rch16/SmartCrutch/ExerciseTracker/Figures/Skeletal Profile - Arm Raises (ex 1).png

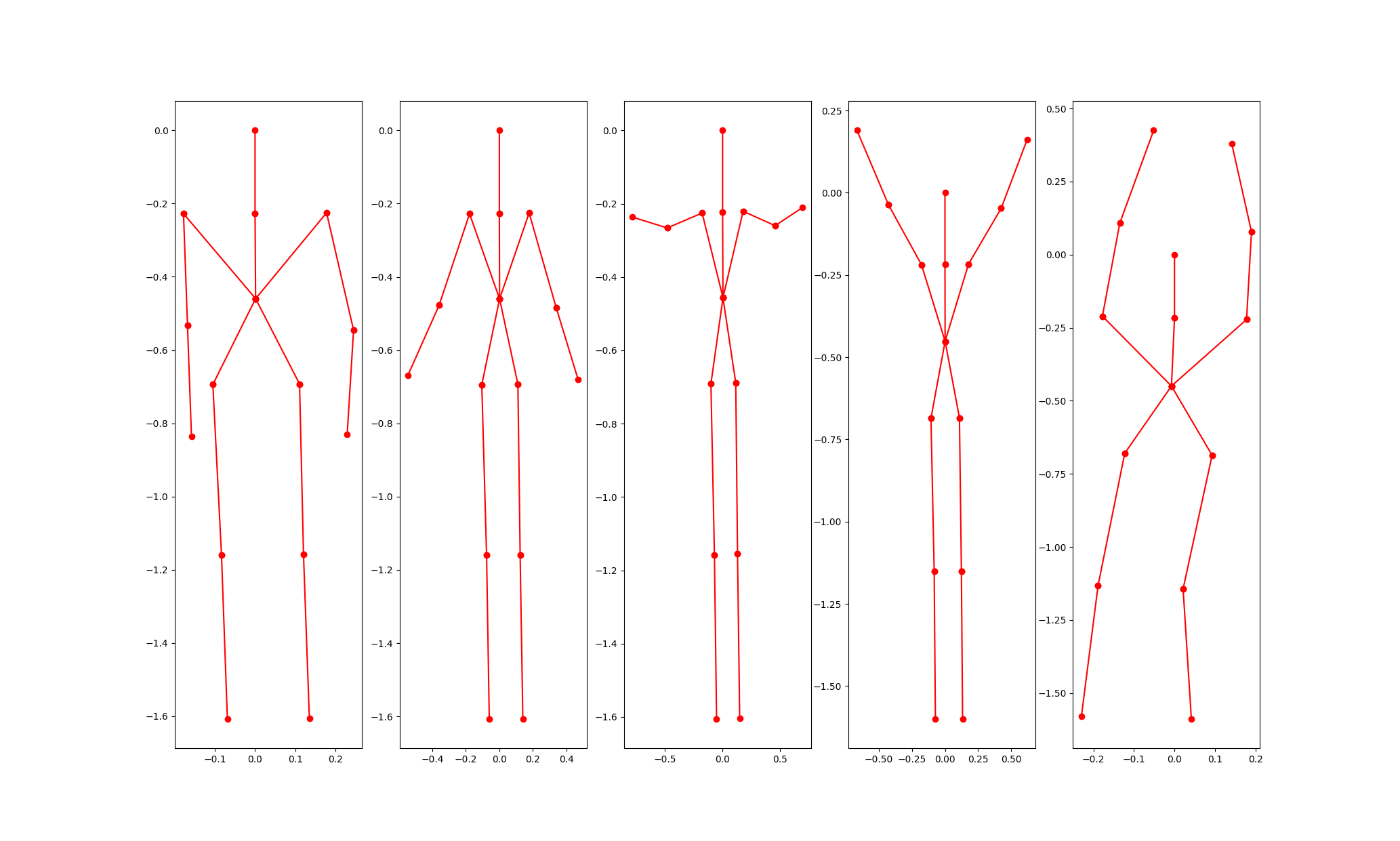
ExerciseTracker/Figures/Skeletal Profile - Arm Raises (ex 1).png
