rch16/SmartCrutch/ExerciseTracker/Figures/Skeletal Profile - Left Knee Raise (ex 3).png

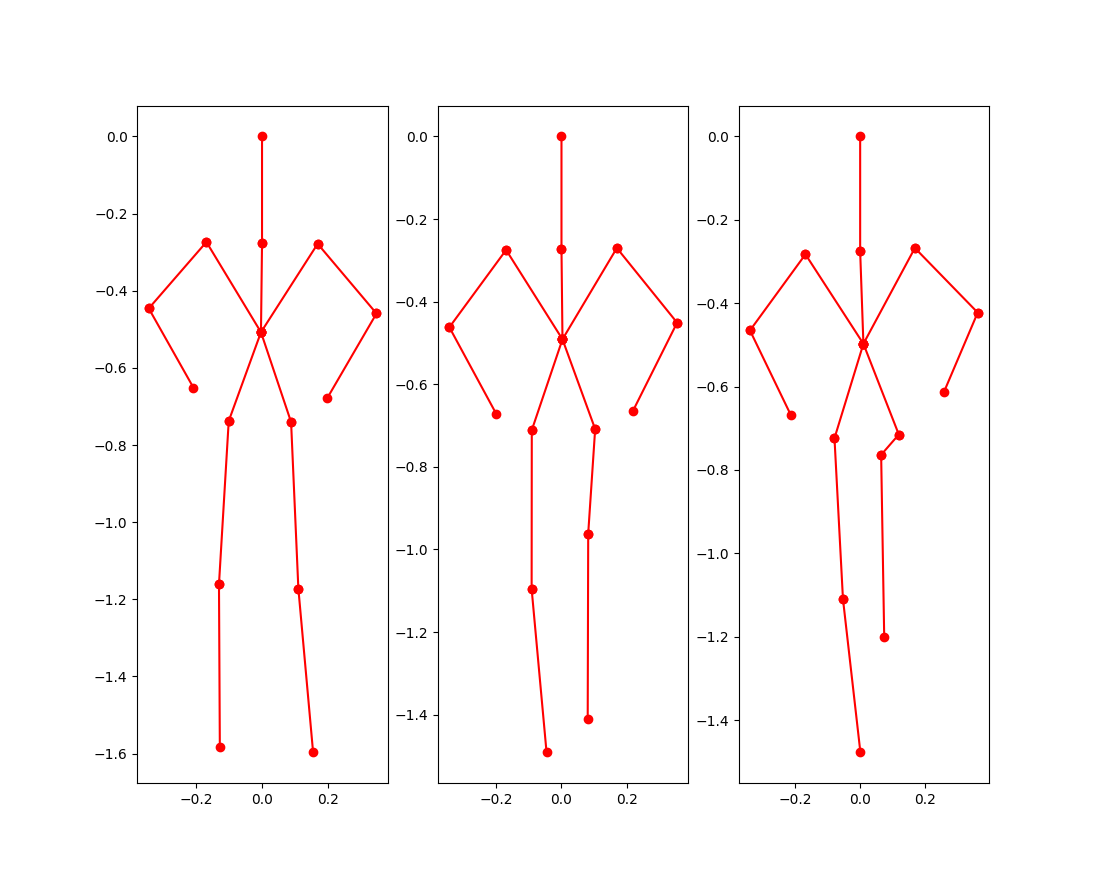
ExerciseTracker/Figures/Skeletal Profile - Left Knee Raise (ex 3).png
