rch16/SmartCrutch/ExerciseTracker/Figures/Skeletal Profile - Left Lateral Leg Raise (ex 2).png

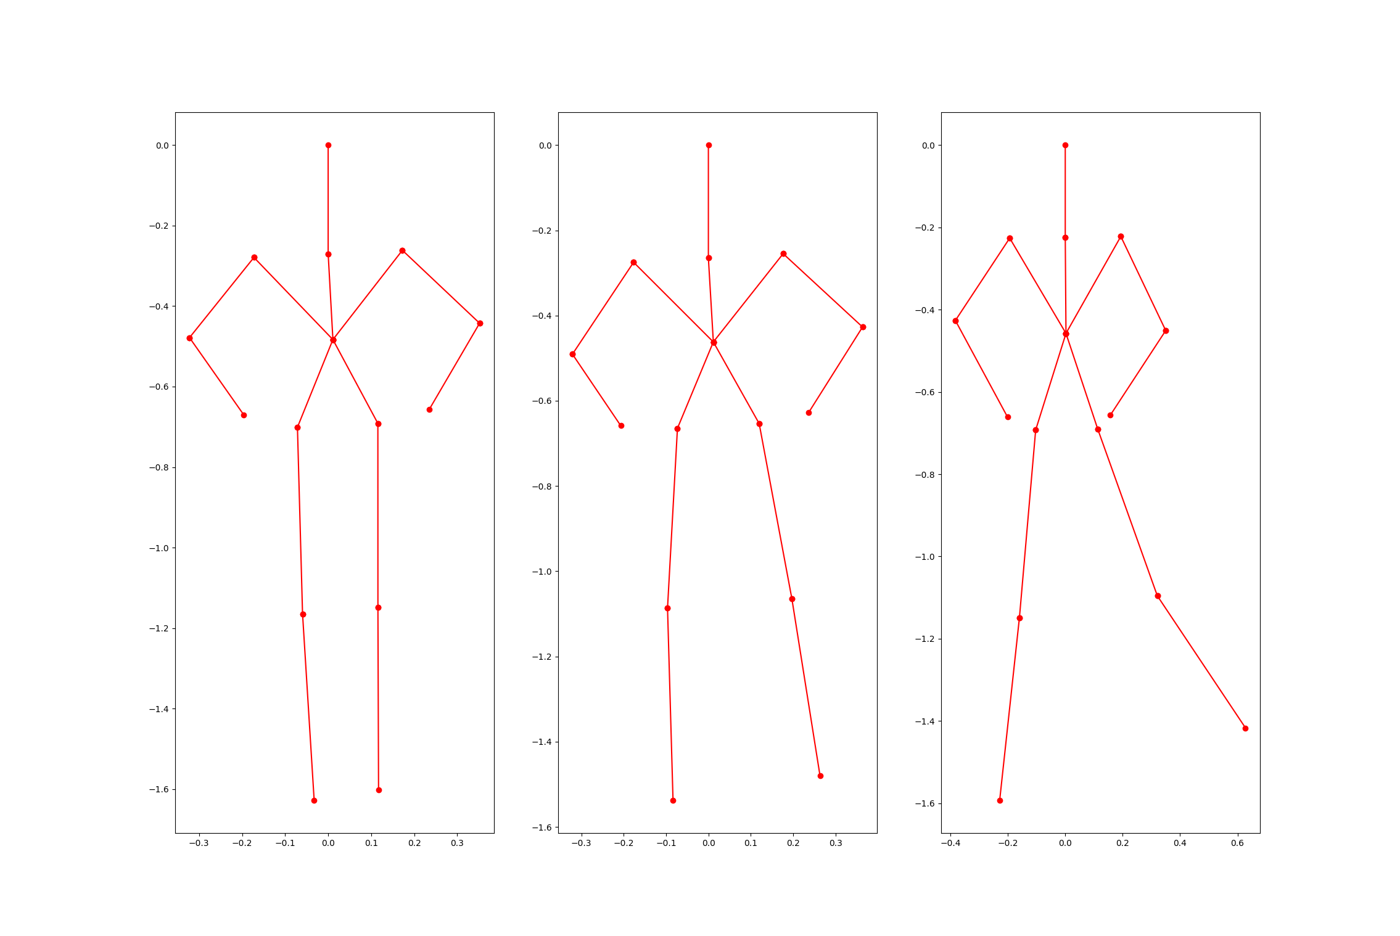
ExerciseTracker/Figures/Skeletal Profile - Left Lateral Leg Raise (ex 2).png
