rch16/SmartCrutch/ExerciseTracker/Figures/Skeletal Profile - Right Knee Raise (ex 4).png

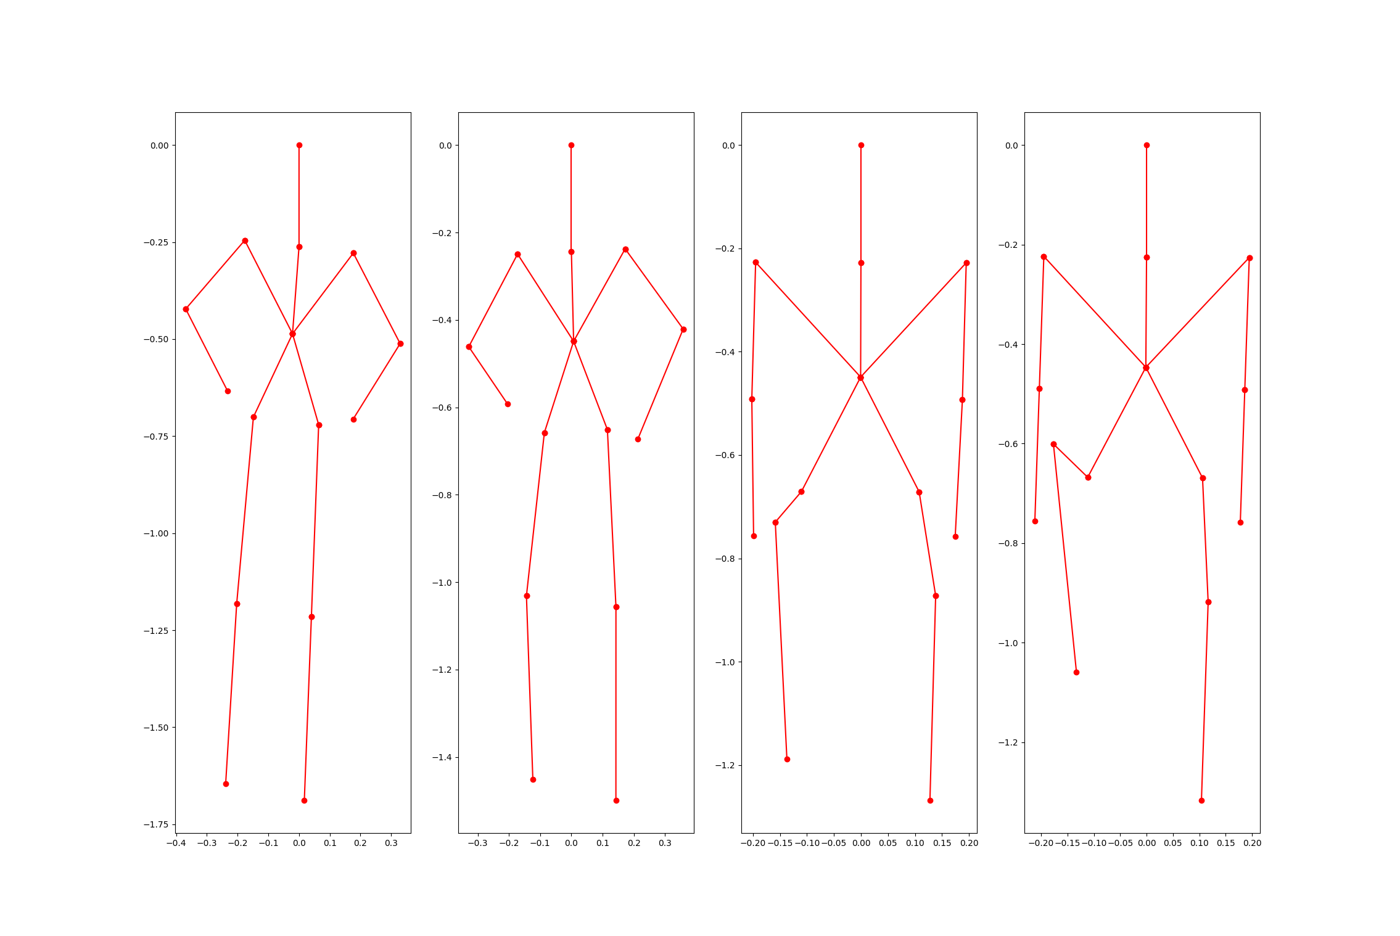
ExerciseTracker/Figures/Skeletal Profile - Right Knee Raise (ex 4).png
