rch16/SmartCrutch/SmartCrutches/FullSystem/CrutchSystem/full_system/full_system.ino

#include <ESP8266WiFi.h>
#include <Wire.h>
#include <WiFiClientSecure.h>
#include <StackThunk.h>

#include "FS.h"
#include "HX711.h"

// Parameter Config
#define SENSOR_SAMPLE_INTERVAL 10000 // Interval between individual IMU/Weight samples in microseconds
#define SENSOR_SAMPLE_SIZE 300 // Number of sensor samples in each period
#define DAILY_SAMPLES 100 // Number of gait samples per day

// i2c addresses
#define MPU9250_ADDRESS 0x68
#define MAG_ADDRESS 0x0C

// Range configuration bytes
#define GYRO_FULL_SCALE_250_DPS 0x00 
#define GYRO_FULL_SCALE_500_DPS 0x08
#define GYRO_FULL_SCALE_1000_DPS 0x10
#define GYRO_FULL_SCALE_2000_DPS 0x18
 
#define ACC_FULL_SCALE_2_G 0x00 
#define ACC_FULL_SCALE_4_G 0x08
#define ACC_FULL_SCALE_8_G 0x10
#define ACC_FULL_SCALE_16_G 0x18

// Pin Definitions
#define LOAD_DOUT_PIN 14
#define LOAD_CLK_PIN 12

#define LED_RED_PIN 2
#define LED_BLUE_PIN 0
#define LED_GREEN_PIN 16
#define MOTOR_PIN 15

// initialise hx711
HX711 scale(LOAD_DOUT_PIN, LOAD_CLK_PIN);

// Connection settings
const char* host = "script.google.com";
const int httpsPort = 443; 
String SCRIPT_ID = "AKfycbyt1zJXaOvHo2_cz7Mfp6ivhan6XcGtnQO_UQzGzq6ECh3G4Zgj";
const int NUM_NETWORKS = 4;
const String SSIDS[NUM_NETWORKS] = {"Fellas WiFi", "Closed Network", "BHIPX", "BTHub6-3G9R"};
const String PASSWORDS[NUM_NETWORKS] = {"Silverton4ever", "portugal1", "123456789", "6Dtw3dLDwdRW"};
const char* ssid     = "BHIPX"; //"BTHub6-3G9R"; //"Fellas WiFi";
const char* password = "123456789"; //"6Dtw3dLDwdRW"; //"Silverton4ever";

// Initial time
long oldTime;
long newTime;
long startTime;

// Loadcell reading
long zeroFactor; // baseline
float upper_bound;
float pressure;
float measure;
float force;
float calibrationFactor = 70;
float threshold; // threshold for amount of weight placed through crutch
float kg_force;

// Search for WiFi networks and join the first recognised
void connectToWifi() {
  WiFi.scanNetworks(false, false);
  Serial.println("Scanning for networks");
  while (WiFi.scanComplete() < 0) {
    delay(200);
    Serial.print(".");
  }
  Serial.println("Found:");
  int numberOfAccessPoints = WiFi.scanComplete();
  for(int n = 0; n < numberOfAccessPoints; n++) {
    Serial.println(WiFi.SSID(n));
  }

  for(int n = 0; n < numberOfAccessPoints; n++) {
    for(int m = 0; m < NUM_NETWORKS; m++) {
      if (SSIDS[m] == WiFi.SSID(n)) {
        Serial.print("Connecting to ");
        Serial.print(SSIDS[m]);
        WiFi.begin(SSIDS[m], PASSWORDS[m]);
        while (WiFi.status() != WL_CONNECTED) {
          Serial.print(".");
          delay(500);
        }
        Serial.println(".");
        Serial.println("WiFi connected");
      }
    }
  }
}

// Attempt to connect with https to a host on a given port
bool connectToSecureHost(BearSSL::WiFiClientSecure *client, const char* host, const int port) {
  int response = client->connect(host, port);
  if (!response) {
    Serial.print("Connection to ");
    Serial.print(host);
    Serial.print(" failed: Returned code ");
    Serial.println(response);
    return false;
  } else {
    Serial.println("Connection success");
  }
  return true;
}

// Same as above but http
bool connectToInsecureHost(WiFiClient *client, const char* host, const int port) {
  Serial.println(host);
  Serial.println(port);
  int response = client->connect(host, port);
  if (!response) {
    Serial.print("Connection to ");
    Serial.print(host);
    Serial.print(" failed: Returned code ");
    Serial.println(response);
    return false;
  } else {
    Serial.println("Connection success");
  }
  return true;
}

// Appends `line` to the GSheet
bool sendData(String line) {
  WiFiClientSecure client;
  client.setInsecure();
  Serial.print("Connecting to ");
  Serial.println(host);
  if (!connectToSecureHost(&client, host, httpsPort)) {
    Serial.println("Failed to connect to script host");
    return false;
  }

  String url = String("/macros/s/" + SCRIPT_ID + "/exec?data=" + line);
  Serial.print("requesting URL: ");
  Serial.println(url);

  //get the sensor data in script format using get method
  client.print(String("GET ") + url + " HTTP/1.1\r\n" +
         "Host: " + host + "\r\n" +
         "User-Agent: BuildFailureDetectorESP8266\r\n" +
         "Connection: close\r\n\r\n");

  if (!client.find("HTTP/1.1")) // skip HTTP/1.1
    return false;
  int st = client.parseInt(); // parse status code
  if (st == 200)
    return true;
  return false;
}

// This function read Nbytes bytes from I2C device at address Address. 
// Put read bytes starting at register Register in the Data array. 
void I2Cread(uint8_t Address, uint8_t Register, uint8_t Nbytes, uint8_t* Data) {
  // Set register address
  Wire.beginTransmission(Address);
  Wire.write(Register);
  Wire.endTransmission();
  
  // Read Nbytes
  Wire.requestFrom(Address, Nbytes);
  uint8_t index=0;
  while (Wire.available())
  Data[index++]=Wire.read();
}

// Write a byte (Data) in device (Address) at register (Register)
void I2CwriteByte(uint8_t Address, uint8_t Register, uint8_t Data) {
  // Set register address
  Wire.beginTransmission(Address);
  Wire.write(Register);
  Wire.write(Data);
  Wire.endTransmission();
}

// Retrieve the current timestamp from worldclock api. Returns a string eg "currentDateTime":"2019-11-26T09:49Z"
String getCurrentTimestamp() {
  WiFiClient client;
  String response = "";
  Serial.print("Connecting to worldclockapi.com");
  if (!connectToInsecureHost(&client, "www.worldclockapi.com", 80)) {
    return "Error connecting to worldclockapi.com";
  }
  client.println("GET /api/json/utc/now HTTP/1.1\r\nHost: worldclockapi.com\r\n");
  client.println("Connection: close");
  client.println();
  String line = client.readStringUntil('"currentDateTime"');
  line = client.readStringUntil(',');
  line = client.readStringUntil(',');
  Serial.println(line);
  return(line);
}
 
// Runs on ESP boot
void setup() {
  Serial.begin(115200);
  connectToWifi();
  Wire.begin();
  SPIFFS.begin();
  
  // Set accelerometers low pass filter at 5Hz
  I2CwriteByte(MPU9250_ADDRESS,29,0x06);
  // Set gyroscope low pass filter at 5Hz
  I2CwriteByte(MPU9250_ADDRESS,26,0x06);
  
  
  // Configure gyroscope range
  I2CwriteByte(MPU9250_ADDRESS,27,GYRO_FULL_SCALE_1000_DPS);
  // Configure accelerometers range
  I2CwriteByte(MPU9250_ADDRESS,28,ACC_FULL_SCALE_4_G);
  // Set by pass mode for the magnetometers
  I2CwriteByte(MPU9250_ADDRESS,0x37,0x02);
  
  // Request continuous magnetometer measurements in 16 bits
  I2CwriteByte(MAG_ADDRESS,0x0A,0x16);
 
  // Configure load cell
  scale.set_scale();
  scale.tare(); // Reset the scale to 0

  // initialize led pins
  pinMode(LED_RED_PIN, OUTPUT);
  pinMode(LED_GREEN_PIN, OUTPUT);
  pinMode(LED_BLUE_PIN, OUTPUT);
  // start off
  digitalWrite(LED_RED_PIN, LOW);
  digitalWrite(LED_GREEN_PIN, LOW);
  digitalWrite(LED_BLUE_PIN, LOW);

  // initialize motor pin
  pinMode(MOTOR_PIN, OUTPUT);
  // start off
  digitalWrite(MOTOR_PIN, LOW);

  // Get a baseline reading
  Serial.println("Remove weight from the crutch for baseline reading");
  zeroFactor = scale.read_average();
  Serial.println("Ok.");
  pinMode(13, OUTPUT);

  // Store initial time
  oldTime = micros();
  startTime = micros();
}

// This is a solution to avoid the use of a real time clock module
// We upload current datetime and corresponding millis() value to GSheet
// Where millis is the number of milliseconds since ESP boot. It overflows every 50 days.
bool uploadDatetimeMillis() {
  Serial.println("Uploading new datetime");
  if(sendData(getCurrentTimestamp() + ",Arduino_milliseconds=" + millis()))
    Serial.println("Datetime upload successful");
    return true;
  return false;
}

// Returns a float of weight applied through crutch in kg
float collectWeightMeasurement(){
  // take reading from sensor in grams
  force = scale.get_units(), 10;
  // convert to kg
  kg_force = abs(force)/1000.00;
  return(kg_force);
}

// Compare weight on crutch to a pre configured value to determine if the crutch is in use
bool crutchInUse() {
  scale.set_scale(calibrationFactor);
  kg_force = collectWeightMeasurement();
  if(abs(kg_force) >= 1){
    return true;
  }
  return false;
}
// Compare the weight through crutch with the threshold and alert user if weight is too high
void checkWeight(int weight_threshold) {
  kg_force = collectWeightMeasurement();
 
  // if too much force is being placed through the crutch, light led and vibrate motor
  Serial.println(kg_force);
  Serial.println(weight_threshold);
  if (abs(kg_force) > weight_threshold){
    // on
    digitalWrite(LED_RED_PIN, HIGH);
    digitalWrite(MOTOR_PIN, HIGH);
  } else {
    // off
    digitalWrite(LED_RED_PIN, LOW);
    digitalWrite(MOTOR_PIN, LOW);
  }
}

// Collect a gait sample with IMU and load cell and write it to memory
bool collectGaitSample() {
  File appendLog = SPIFFS.open("/log.csv", "a");
  appendLog.print("Start_of_sample|");

  for(int n = 0; n <= SENSOR_SAMPLE_SIZE; n++) {
    newTime = micros();
    while((newTime - oldTime) < SENSOR_SAMPLE_INTERVAL){
      newTime = micros();
    }
    oldTime = micros();
    // Read accelerometer and gyroscope
    uint8_t Buf[14];
    I2Cread(MPU9250_ADDRESS,0x3B,14,Buf);

    
//    Serial.println(micros());
//    kg_force = collectWeightMeasurement();
//    Serial.println(micros());
    // Create 16 bits values from 8 bits data
    // Accelerometer
    int16_t ax=-(Buf[0]<<8 | Buf[1]);
    int16_t ay=-(Buf[2]<<8 | Buf[3]);
    int16_t az=Buf[4]<<8 | Buf[5];
    
    // Gyroscope
    int16_t gx=-(Buf[8]<<8 | Buf[9]);
    int16_t gy=-(Buf[10]<<8 | Buf[11]);
    int16_t gz=Buf[12]<<8 | Buf[13];

    // Append gyroscope and accelerometer data to the log
    appendLog.print(millis());
    appendLog.print(',');
    appendLog.print(micros());
    appendLog.print(',');
    appendLog.print(ax);
    appendLog.print(',');
    appendLog.print(ay);
    appendLog.print(',');
    appendLog.print(az);
    appendLog.print(',');
    appendLog.print(gx);
    appendLog.print(',');
    appendLog.print(gy);
    appendLog.print(',');
    appendLog.print(gz);
    appendLog.print(',');
    
    // Append load cell data to the log
//    appendLog.print(kg_force);
    appendLog.print('|');
  }
  appendLog.print("End_of_sample|");
  appendLog.close();
}

// Attempt to connect to Google, determining if there is an internet connection
bool wifiConnected() {
  WiFiClient client;
  String response = "";
  Serial.print("Connecting to google.com");
  if (!connectToInsecureHost(&client, "google.com", 80)) {
    return false;
  }
  return true;
}

// Overwrite the file in memory with a blank one
void clearData() {
  File writeLog = SPIFFS.open("/log.csv", "w");
  writeLog.close();
}

// Attempt to upload a gait sample to the GSheet, returning false if unsuccesful and true if successful
bool uploadNewData() {
  Serial.println("Uploading new data");
  if (!sendData("New_upload"))
    return false;
  if (!uploadDatetimeMillis())
    return false;
  File readLog = SPIFFS.open("/log.csv", "r");
  String line = readLog.readStringUntil('|');
  while(line.length() > 0) {
    line = readLog.readStringUntil('|');
    Serial.println(line);
  }
  if (!sendData("Upload end"))
    return false;
  readLog.close();
  clearData();
  return true;
}

int getWeightThreshold() {
  WiFiClient client;
  String response = "";
  Serial.print("Connecting to weight threshold api");
  if (!connectToInsecureHost(&client, "a1cc6d56.ngrok.io", 80)) {
  }
  client.println("GET /api/get_threshold HTTP/1.1\r\nHost: a1cc6d56.ngrok.io\r\n");
  String line = client.readStringUntil('\n');
  line = client.readStringUntil('\n');
  line = client.readStringUntil('\n');
  line = client.readStringUntil('\n');
  line = client.readStringUntil('\n');
  line = client.readStringUntil('\n');
  line = client.readStringUntil('\n');
  line = client.readStringUntil('\n');
  Serial.println(line);
  client.println("Connection: close");
  client.println();
  return(line.toInt());
}

int samples_today = 0;
bool uploaded_new_data = true;
int weight_threshold = 600;
int loops = 0;

void loop() {
  checkWeight(weight_threshold);
  delay(10);
  loops++;
  if (loops == 200) {
    loops = 0;
    Serial.println("Getting weight threshold");
    weight_threshold = getWeightThreshold();
  }
}
