rch16/SmartCrutch/(commit log)

2019-11-27 implementation of force sensor for individual demo
2019-11-27 force sensor and imu working in parallel with data being pushed to the google sheet
2019-11-27 fixing 0 pressure problem (incomplete)
    [full_system.ino]
2019-11-28 reduced number of samples
2019-11-28 imu demonstration code
2019-12-05 get rgb led to work
2019-12-05 light led and vibrate motor if too much weight placed through
    [force_demo.ino]
2019-12-17 Added app to repo
    [app_bar_main.xml]
